TomFoerster/Double-Z-Brake-Board/Double_Z_Brake_SMD_Relay/Z_Brake.kicad_pcb

## KiCad design Double_Z_Brake_SMD_Relay/Z_Brake.kicad_pcb (2023-03-20)

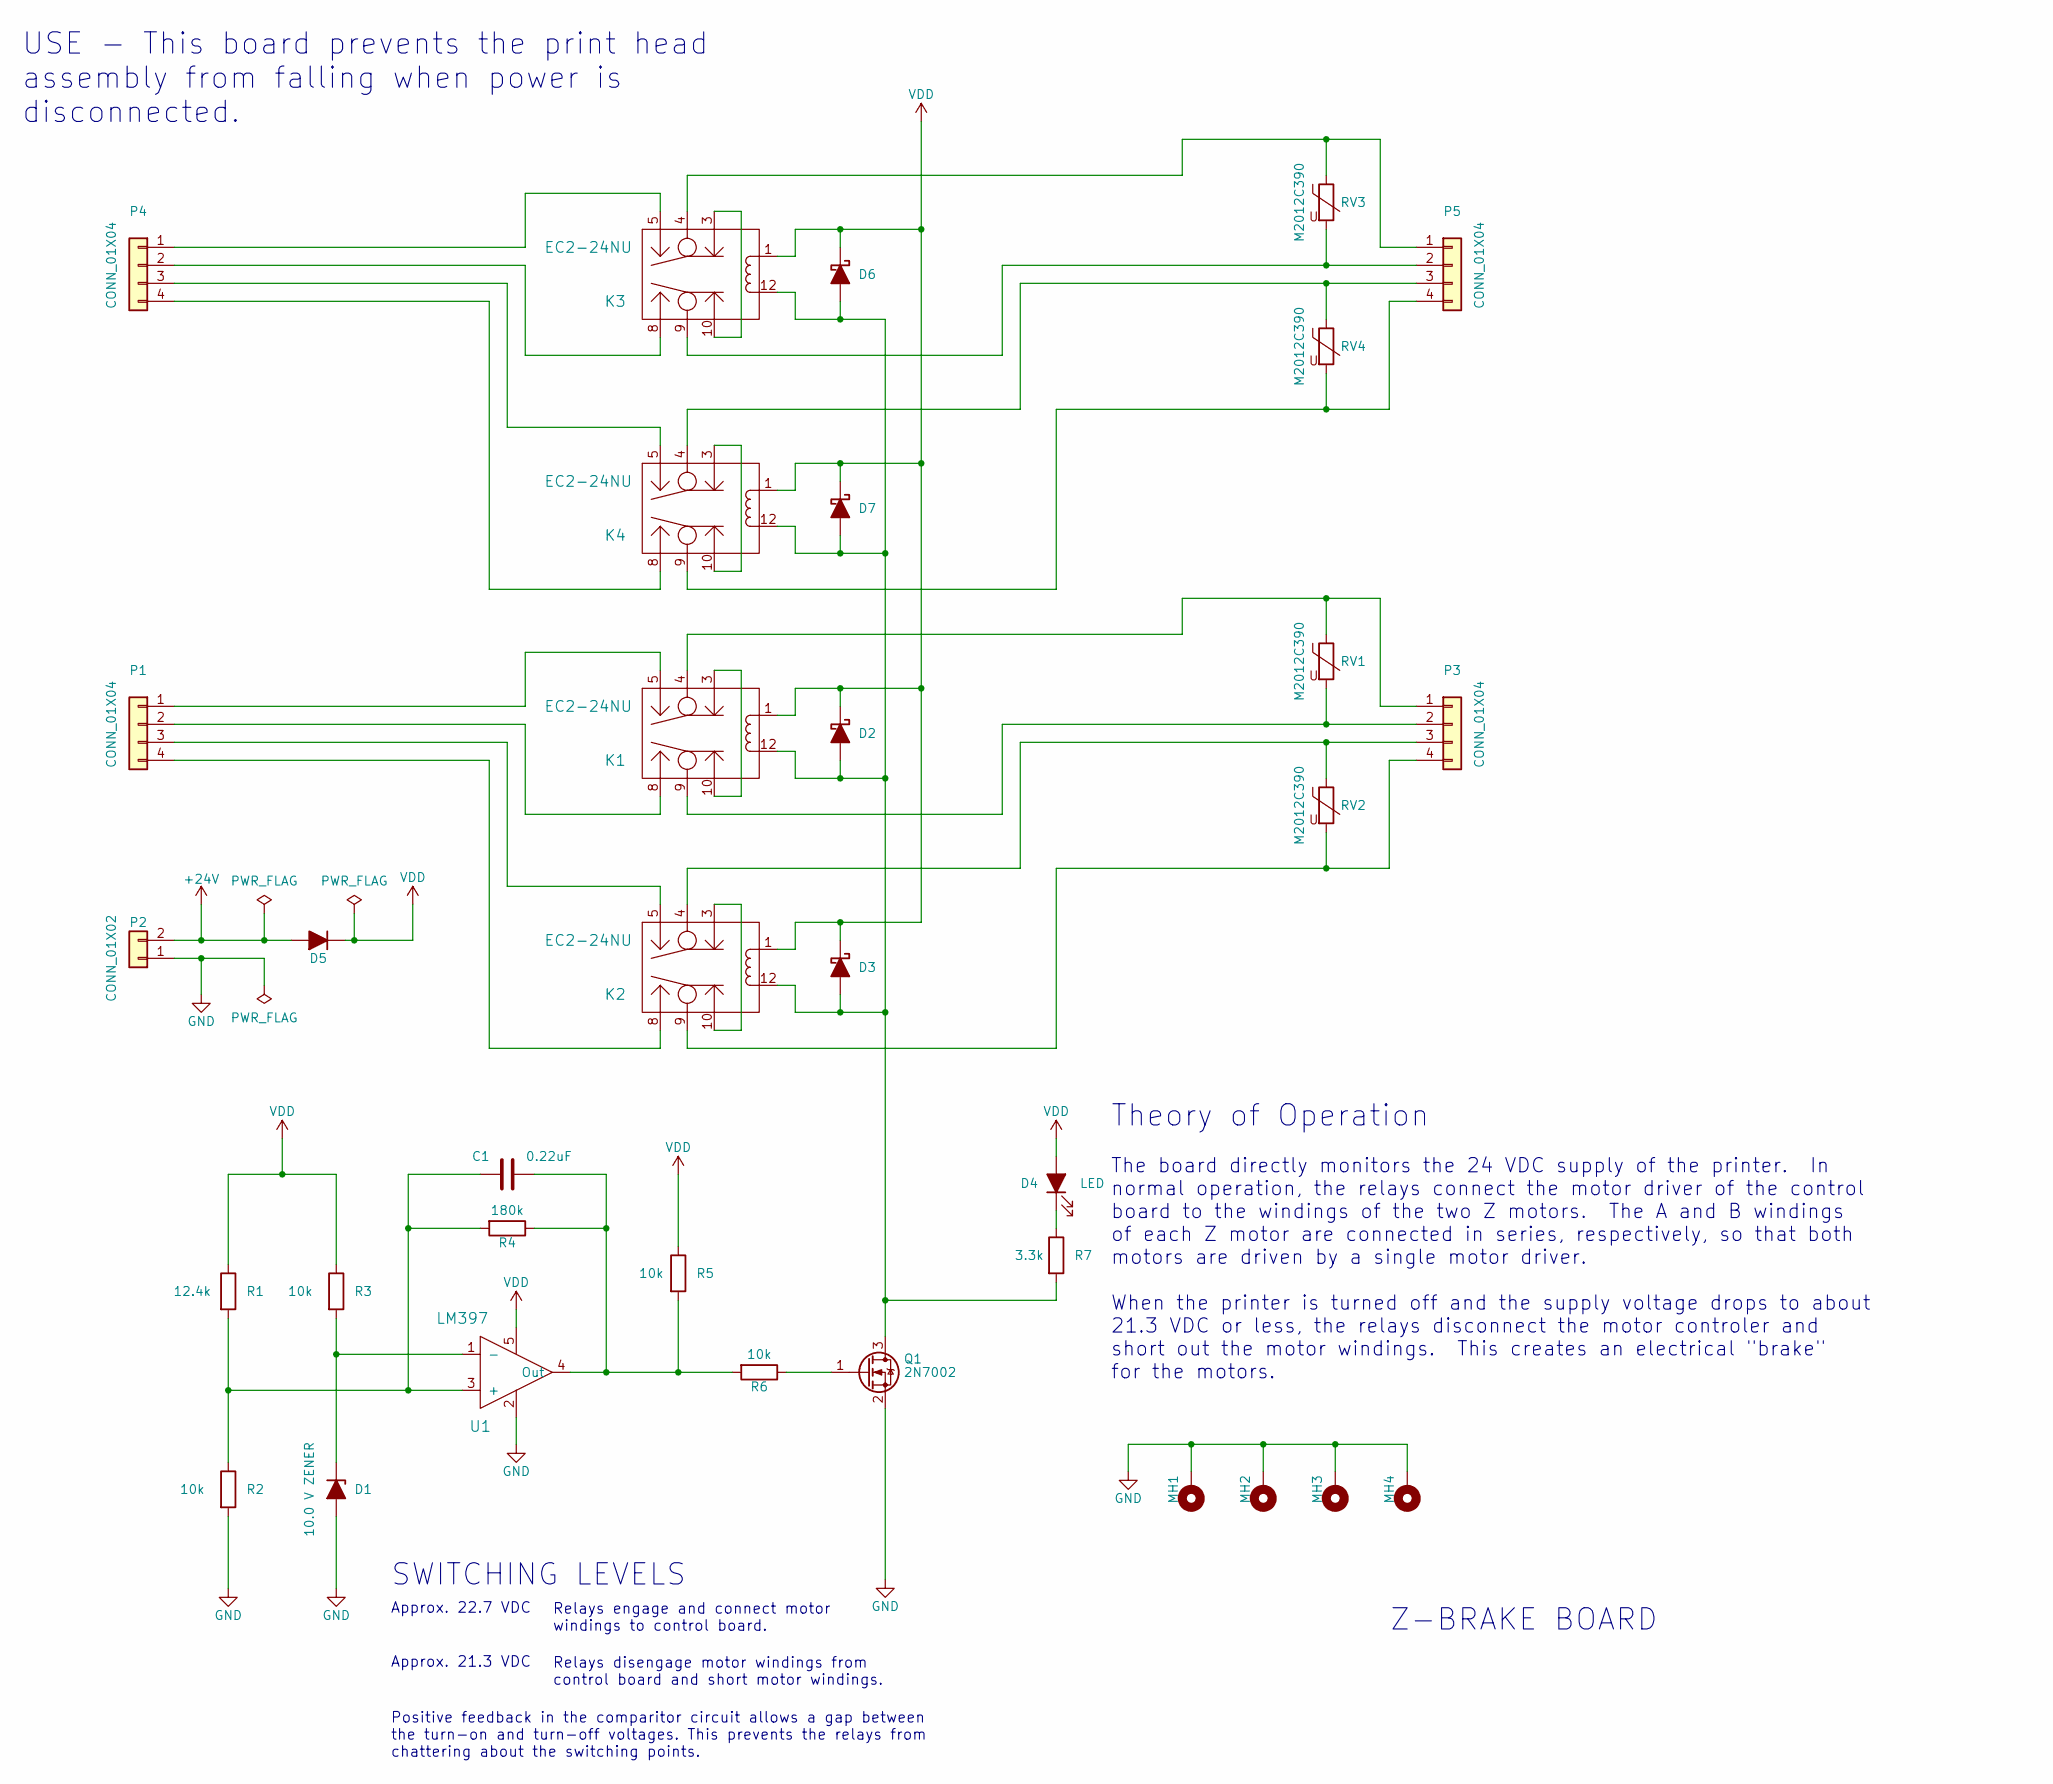
[picture p1: schematic Z_Brake.kicad_sch, Double Z-Brake Board]

Parts:
C1: 0.22uF; C_0603_1608Metric_Pad1.08x0.95mm_HandSolder; MPN CL10B224KB8VPNC
D1: 10.0 V ZENER; D_SMA_Handsoldering; MPN SMAZ10-13-F
D2, D3, D6, D7: D_Schottky_ALT; D_SOD-123; MPN BAT48ZFILM
D4: LED; LED_0603_1608Metric_Pad1.05x0.95mm_HandSolder; MPN LTST-C190YKT
D5: D_ALT; D_SMA_Handsoldering; MPN CDBA340-HF
K1, K2, K3, K4: EC2-24NU; Relay_DPDT_Kemet_EE2_NU; MPN EC2-24NU
MH1, MH2, MH3, MH4: CONN_01X01; MountingHole_2.5mm_Pad
P1, P3, P4, P5: CONN_01X04; Molex-70543-0038-0-0-MFG; MPN 0705430003
P2: CONN_01X02; MOLEX_0705430001; MPN 0705430001
Q1: 2N7002; SOT-23_Handsoldering; MPN 2N7002 TR PBFREE
R1: 12.4k; R_0603_1608Metric_Pad0.98x0.95mm_HandSolder; MPN RC0603FR-0712K4L
R2, R3, R5, R6: 10k; R_0603_1608Metric_Pad0.98x0.95mm_HandSolder; MPN RC0603FR-0710KL
R4: 180k; R_0603_1608Metric_Pad0.98x0.95mm_HandSolder; MPN RC0603FR-07180KL
R7: 3.3k; R_0603_1608Metric_Pad0.98x0.95mm_HandSolder; MPN RC0603FR-073K3L
RV1, RV2, RV3, RV4: M2012C390; R_0805_2012Metric_Pad1.20x1.40mm_HandSolder; MPN AVR-M2012C390KT6AB
U1: LM397; SOT-23-5_HandSoldering; MPN LM397MF/NOPB

Connections:
+24V: D5.2 (A), P2.2
GND: D1.2 (A), MH1.1, MH2.1, MH3.1, MH4.1, P2.1, Q1.2 (S), R2.2, U1.2
unnamed: D1.1 (K), R3.2, U1.1 (-)
unnamed: D2.2 (A), D3.2 (A), D6.2 (A), D7.2 (A), K1.12, K2.12, K3.12, K4.12, Q1.3 (D), R7.2
unnamed: D4.1 (K), R7.1
unnamed: K1.3, K1.10
unnamed: K2.3, K2.10
unnamed: K3.3, K3.10
unnamed: K4.3, K4.10
unnamed: K1.5, P1.1
unnamed: K1.8, P1.2
unnamed: K2.5, P1.3
unnamed: K2.8, P1.4
unnamed: K1.4, P3.1, RV1.1
unnamed: K1.9, P3.2, RV1.2
unnamed: K2.4, P3.3, RV2.1
unnamed: K2.9, P3.4, RV2.2
unnamed: K3.5, P4.1
unnamed: K3.8, P4.2
unnamed: K4.5, P4.3
unnamed: K4.8, P4.4
unnamed: K3.4, P5.1, RV3.1
unnamed: K3.9, P5.2, RV3.2
unnamed: K4.4, P5.3, RV4.1
unnamed: K4.9, P5.4, RV4.2
unnamed: Q1.1 (G), R6.1
unnamed: C1.2, R1.2, R2.1, R4.2, U1.3 (+)
unnamed: C1.1, R4.1, R5.2, R6.2, U1.4 (Out)
VDD: D2.1 (K), D3.1 (K), D4.2 (A), D5.1 (K), D6.1 (K), D7.1 (K), K1.1, K2.1, K3.1, K4.1, R1.1, R3.1, R5.1, U1.5

Notes on the sheet:
Theory of Operation
SWITCHING LEVELS
Relays engage and connect motor windings to control board.
Z-BRAKE BOARD
Relays disengage motor windings from control board and short motor windings.
USE - This board prevents the print head assembly from falling when power is disconnected.
The board directly monitors the 24 VDC supply of the printer. In normal operation, the relays connect the motor driver of the control board to the windings of the two Z motors. The A and B windings of each Z motor are connected in series, respectively, so that both motors are driven by a single mot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
Approx. 21.3 VDC
Approx. 22.7 VDC
Positive feedback in the comparitor circuit allows a gap between the turn-on and turn-off voltages. This prevents the relays from chattering about the switching points.

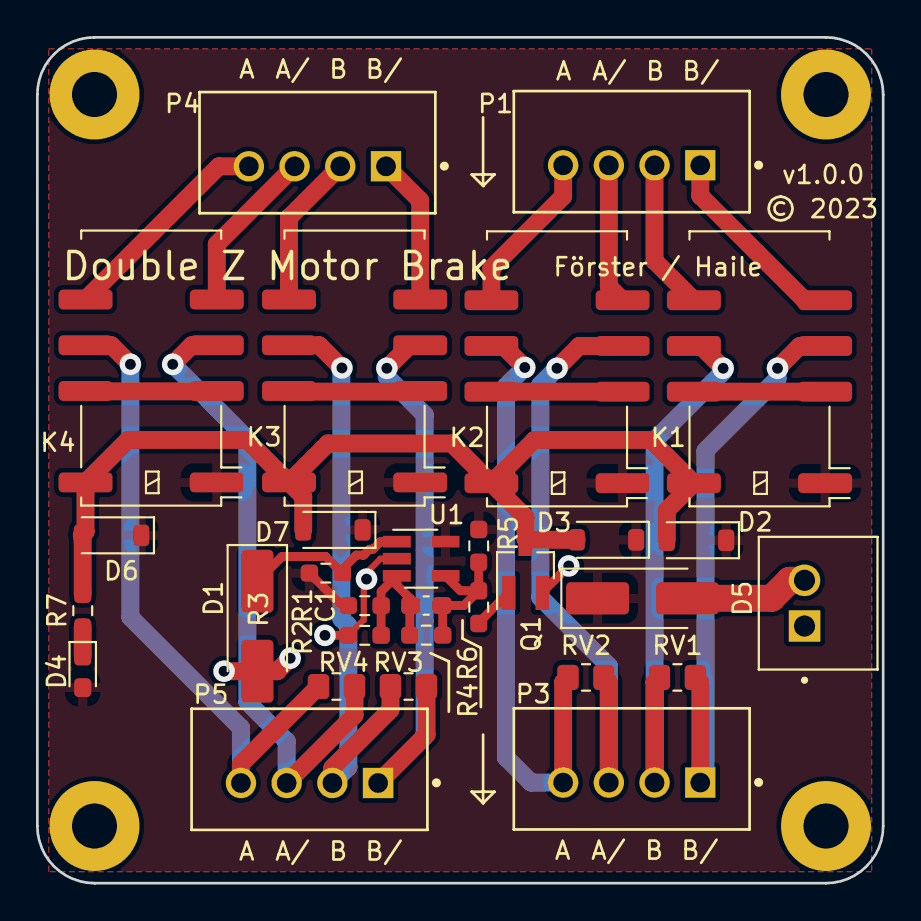
[picture p2: board Z_Brake.kicad_pcb from above]

Board: 2 copper layers, 47.0 x 47.0 mm, 34 parts (0 on the bottom side), 29 nets.
