TomFoerster/Double-Z-Brake-Board/(notices)

Notices in the files:
Double_Z_Brake_SMD_Relay/Z_Brake.kicad_pcb:
© 2023
